linklayer/cantact-pro-hw/label-top.png

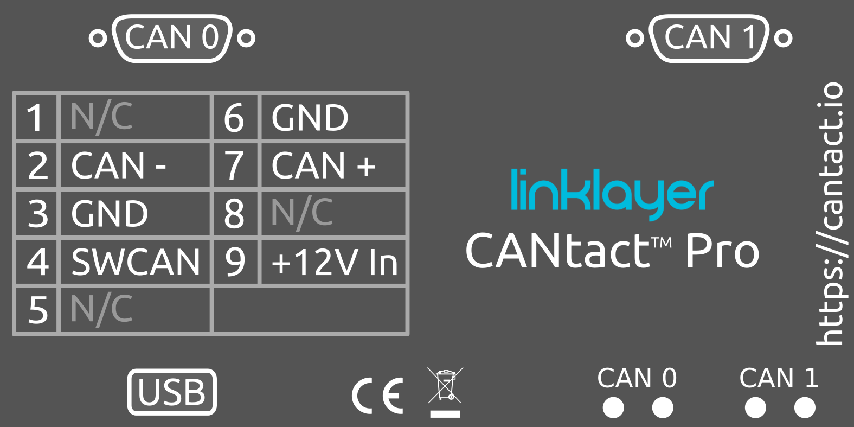
label-top.png
