linklayer/cantact-pro-hw/pcb.step

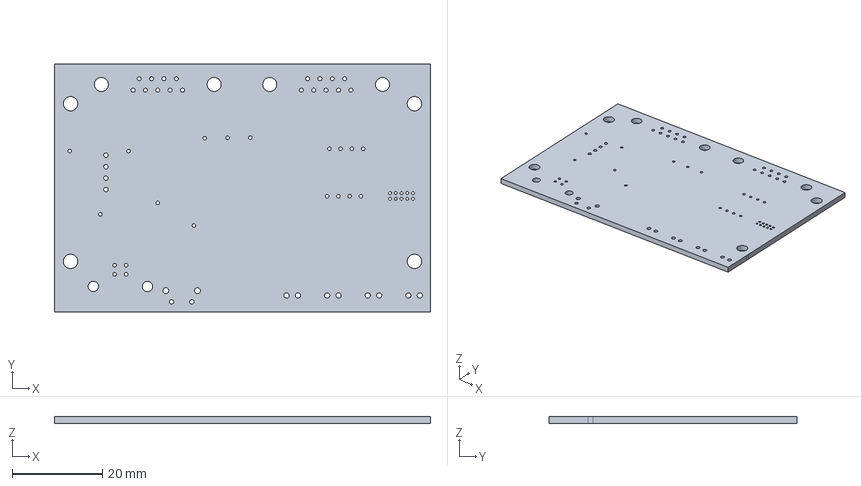
[picture p2: CAD file, 2020-08-20]
pcb.step
83.3 x 54.9 x 1.60 mm
