linklayer/cantact-pro-hw/cantactpro.pdf

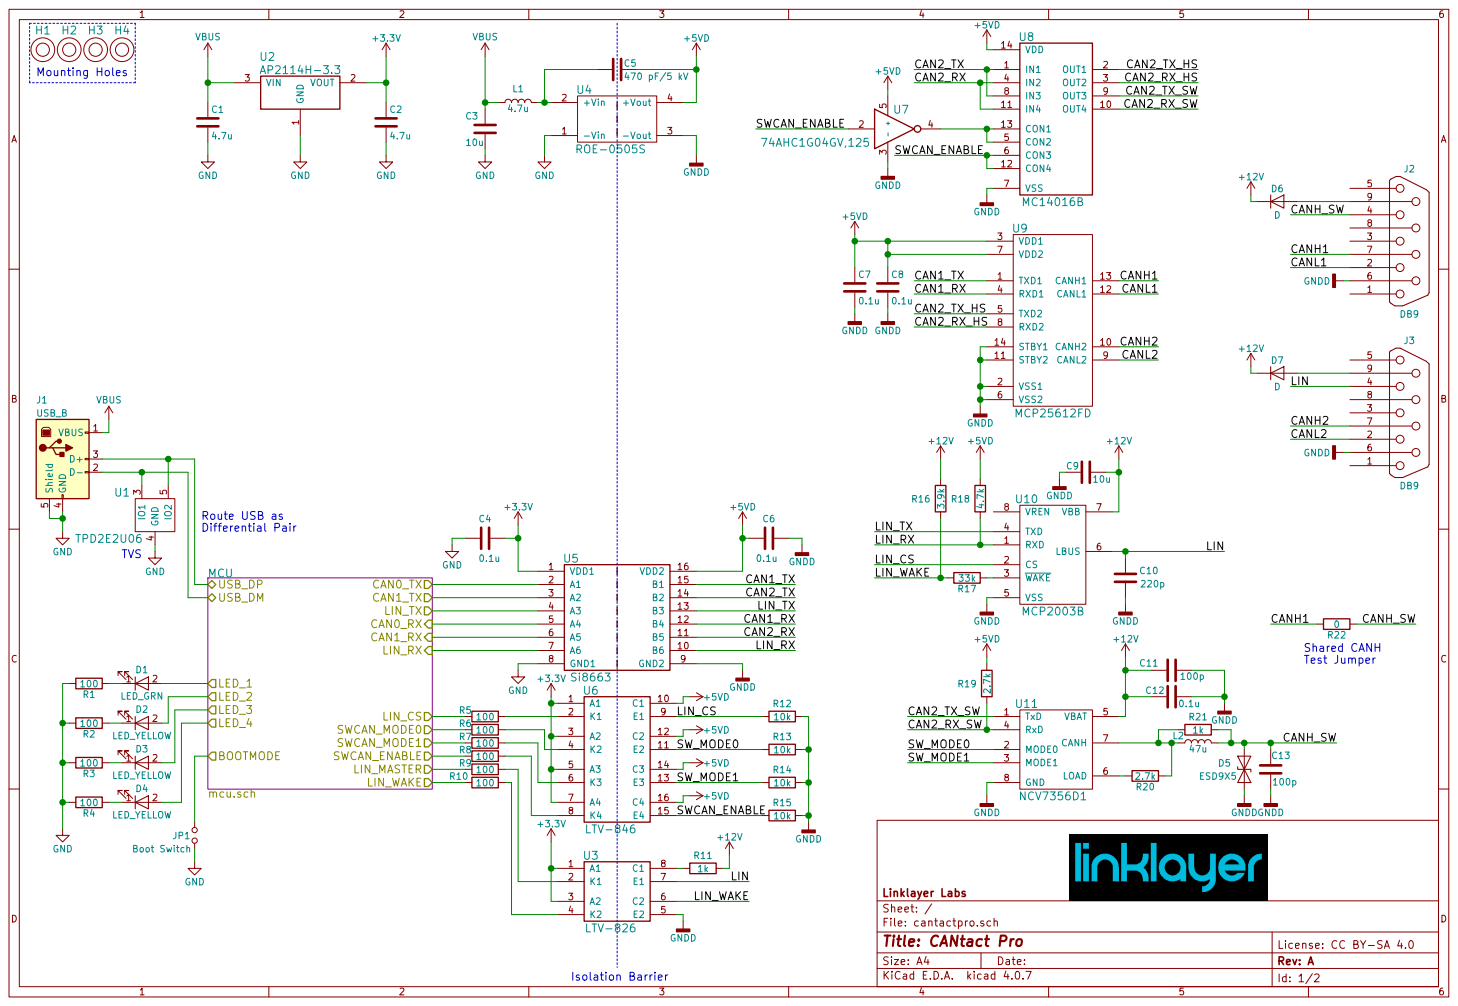
[picture p3: page 1]

LIN_RX

RXD 1 CS 2 WAKE 3 TXD 4 VSS 5

CAN0_TX CAN1_TX CAN1_RX SWCAN_MODE0 SWCAN_MODE1

File: cantactpro.sch Sheet: / Linklayer Labs

Id: 1/2 Title: CANtact Pro

License: CC BY-SA 4.0
