linklayer/cantact-pro-hw/cantactpro.kicad_pcb

## KiCad design cantactpro.kicad_pcb (2020-08-20)

Schematic: cantactpro.sch, CANtact FD

Parts:
C1, C2: 4.7u; C_0805; MPN CL21A475KAQNNNG
C3: 10u; C_0805; MPN CL21A106KPFNNNG
C4, C7, C11: 0.1u; C_0603; MPN CC0603ZRY5V9BB104
C5, C6: 470 pF/5 kV; C_1812; MPN 202S43W471KV4E
C8, C9: 0.1u; C_0603; MPN CL10F104ZO8NNNC
C10, C12: 100p; C_0603; MPN 885012206077
D1, D3: LED_GRN; LED_0603; MPN LTST-S270KGKT
D2, D4: LED_RED; LED_0603; MPN LTST-S270KRKT
D5: ESD9X5; SOD-923; MPN ESD9X5.0ST5G
D6: D; D_SMA; MPN S1G
H1, H2, H3, H4: MOUNT_HOLE; MountingHole_3.2mm_M3
J1: USB_B; MPN USB-B1HSB6
J2, J3: DB9; LD09P; MPN LD09P13A4GX00LF
JP1: Boot Switch; TE_1825027-5; MPN 1825027-5
L1: 4.7u; L_0805; MPN LQM21PN4R7NGRD
L2: 47u; L_1206; MPN LB3218T470K
LP1, LP2, LP3, LP4: Light Pipe; SLP3-150-zzz-x; MPN SLP3-150-100-F
R1, R2, R3, R4, R5, R6, R7: 100; R_0603; MPN ESR03EZPJ102
R8: 10k; R_0603; MPN RC0603JR-0710KL
R9, R10: 2.7k; R_0603; MPN RMCF0603JT2K70
R11: 1k; R_0603; MPN RC0603JR-071KL
TP1, TP2, TP3, TP4, TP5, TP6, TP7, TP8, TP9, TP10, TP11, TP12, TP13, TP14, TP15, TP16: TEST; Measurement_Point_Round-TH_Small
U1: TPD2E2U06; SOT-553; MPN TPD2E2U06DRLR
U2: AP2114H-3.3; SOT-223; MPN AP2114H-3.3TRG1
U3: ROE-0505S; MPN ROE-0505S
U4: Si864x; SOIC-16_3.9x9.9mm_Pitch1.27mm; MPN SI8642AB-B-IS1R
U5: LTV-846; SMD-16; MPN LTV-846S
U6, U11: 74LVC1G3157; SOT-363_SC-70-6; MPN SN74LVC1G3157DCKR
U7: NCV7356D1; SOIC-8_3.9x4.9mm_Pitch1.27mm; MPN NCV7356D1R2G
U8: MCP25612FD; SOIC-14_3.9x8.7mm_Pitch1.27mm; MPN MCP25612FD-H/SL
U9, U10: NUP2125; SC-70; MPN NUP2125WTT1G

Connections:
+3V3: C2.1, C4.1, TP3.1, U2.2, U2.4, U4.1, U4.7, U5.3, U5.5, U5.7; also elsewhere on the board
+5VD: C5.1, C7.2, C8.1, C9.1, R9.1, TP9.1, U3.4, U4.10, U4.16, U5.10, U5.12, U5.14, U6.5, U8.3, U8.7, U11.5
+12V: C10.1, C11.2, D6.1 (K), U7.5
/12V_DB9: D6.2 (A), J2.9
/CAN0_MODE: R8.2, TP14.1, U5.9, U6.6, U11.6
/CAN0_RX: TP12.1, U4.12, U11.4
/CAN0_RX_HS: U8.4, U11.3
/CAN0_RX_SW: R9.2, U7.4, U11.1
/CAN0_TX: TP10.1, U4.14, U6.4
/CAN0_TX_HS: U6.3, U8.1
/CAN0_TX_SW: U6.1, U7.1
/CAN1_RX: TP13.1, U4.11, U8.8
/CAN1_TX: TP11.1, U4.13, U8.5
/CANH0: J2.7, U8.13, U10.1
/CANH1: J3.7, U8.10, U9.1
/CANH_SW: C12.2, D5.1 (A1), J2.4, L2.2, R11.1
/CANL0: J2.2, U8.12, U10.2
/CANL1: J3.2, U8.9, U9.2
/MCU/BOOTMODE: JP1.1; also elsewhere on the board
/MCU/CAN0_RX: TP6.1, U4.5; also elsewhere on the board
/MCU/CAN0_TX: TP4.1, U4.3; also elsewhere on the board
/MCU/CAN1_RX: TP7.1, U4.6; also elsewhere on the board
/MCU/CAN1_TX: TP5.1, U4.4; also elsewhere on the board
/MCU/LED_1: D1.2 (A); also elsewhere on the board
/MCU/LED_2: D2.2 (A); also elsewhere on the board
/MCU/LED_3: D3.2 (A); also elsewhere on the board
/MCU/LED_4: D4.2 (A); also elsewhere on the board
/MCU/SWCAN_ENABLE: R7.1; also elsewhere on the board
/MCU/SWCAN_MODE0: R5.1; also elsewhere on the board
/MCU/SWCAN_MODE1: R6.1; also elsewhere on the board
/MCU/USB+: J1.3 (D+), U1.5; also elsewhere on the board
/MCU/USB-: J1.2 (D-), U1.3; also elsewhere on the board
/SW_MODE0: TP15.1, U5.13, U7.2
/SW_MODE1: TP16.1, U5.11, U7.3
GND: C1.2, C2.2, C3.2, C4.2, C6.2, J1.4 (GND), J1.5 (Shield), JP1.2, R1.1, R2.1, R3.1, R4.1, TP2.1, U1.4, U2.1, U3.1, U4.2, U4.8; also elsewhere on the board
GNDD: C6.1, C7.1, C8.2, C9.2, C10.2, C11.1, C12.1, D5.2 (A2), J2.3, J2.6, J3.3, J3.6, R8.1, TP8.1, U3.3, U4.9, U4.15, U6.2, U7.8, U8.2, U8.6, U8.11, U8.14, U9.3, U10.3, U11.2
unnamed: C5.2, L1.2, U3.2
unnamed: D1.1 (K), R1.2
unnamed: D2.1 (K), R2.2
unnamed: D3.1 (K), R3.2
unnamed: D4.1 (K), R4.2
unnamed: L2.1, R10.1, R11.2, U7.7
unnamed: R5.2, U5.4
unnamed: R6.2, U5.6
unnamed: R7.2, U5.8
unnamed: R10.2, U7.6
VBUS: C1.1, C3.1, J1.1 (VBUS), L1.1, TP1.1, U2.3; also elsewhere on the board

Notes on the sheet:
Isolation Barrier
Mounting Holes
Light Pipes

Schematic: mcu.sch, CANtact FD

Parts:
C13, C15, C17, C19, C21, C23, C25, C27, C29: 0.01u; C_0603; MPN C0603C103M5RACTU
C14, C16, C18, C20, C22, C24, C26, C28, C32: 0.1u; C_0603; MPN CL10F104ZO8NNNC
C30, C31: 33p; C_0603; MPN CL10C330JB8NNNC
C33: 4.7u; C_0805; MPN CL21A475KAQNNNG
C34: 10u; C_0805; MPN CL21A106KPFNNNG
J4: SWD; Pin_Header_Straight_2x05_Pitch1.27mm; MPN 3220-10-0100-00
R12: 0; R_0603; MPN RC0603JR-070RL
R13: 12.4k; R_0603; MPN ERJ-3EKF1242V
R14, R15: 10k; R_0603; MPN RC0603JR-0710KL
U12: LPC54616J512BD100; LQFP-100_14x14mm_Pitch0.5mm; MPN LPC54616J512BD100E
Y1: 12 MHz; CSM-3X; MPN ECS-120-20-3X-TR

Connections:
+3V3: C13.1, C14.1, C15.1, C16.1, C17.1, C18.1, C19.1, C20.1, C21.1, C22.1, C23.1, C24.1, C25.1, C26.1, C27.1, C28.1, C29.1, C32.1, C33.1, C34.1, J4.1, R14.2, R15.2, U12.1, U12.10, U12.11, U12.21, U12.31, U12.32, U12.33, U12.45, U12.50, U12.54, U12.75, U12.76, U12.99; also elsewhere on the board
/MCU/BOOTMODE: R12.2, U12.90; also elsewhere on the board
/MCU/CAN0_RX: U12.60; also elsewhere on the board
/MCU/CAN0_TX: U12.58; also elsewhere on the board
/MCU/CAN1_RX: U12.5; also elsewhere on the board
/MCU/CAN1_TX: U12.47; also elsewhere on the board
/MCU/ISP0: U12.87
/MCU/ISP1: R12.1, U12.89
/MCU/LED_1: U12.35; also elsewhere on the board
/MCU/LED_2: U12.36; also elsewhere on the board
/MCU/LED_3: U12.37; also elsewhere on the board
/MCU/LED_4: U12.38; also elsewhere on the board
/MCU/RESETN: J4.10, U12.48
/MCU/SWCAN_ENABLE: U12.77; also elsewhere on the board
/MCU/SWCAN_MODE0: U12.83; also elsewhere on the board
/MCU/SWCAN_MODE1: U12.78; also elsewhere on the board
/MCU/SWCLK: J4.4, R15.1, U12.24
/MCU/SWDIO: J4.2, R14.1, U12.25
/MCU/USB+: U12.13; also elsewhere on the board
/MCU/USB-: U12.12; also elsewhere on the board
GND: C13.2, C14.2, C15.2, C16.2, C17.2, C18.2, C19.2, C20.2, C21.2, C22.2, C23.2, C24.2, C25.2, C26.2, C27.2, C28.2, C29.2, C30.1, C31.1, C32.2, C33.2, C34.2, J4.3, J4.5, J4.9, R13.1, U12.2, U12.6, U12.14, U12.22, U12.30, U12.34, U12.49, U12.51, U12.53, U12.71, U12.79, U12.96; also elsewhere on the board
unnamed: C30.2, U12.20, Y1.2
unnamed: C31.2, U12.19, Y1.1
unnamed: R13.2, U12.7
VBUS: U12.9; also elsewhere on the board

Notes on the sheet:
SWD Debug Interface
DNP R14 for MSC Populate for DFU
TODO: CHECK LOAD CAPS

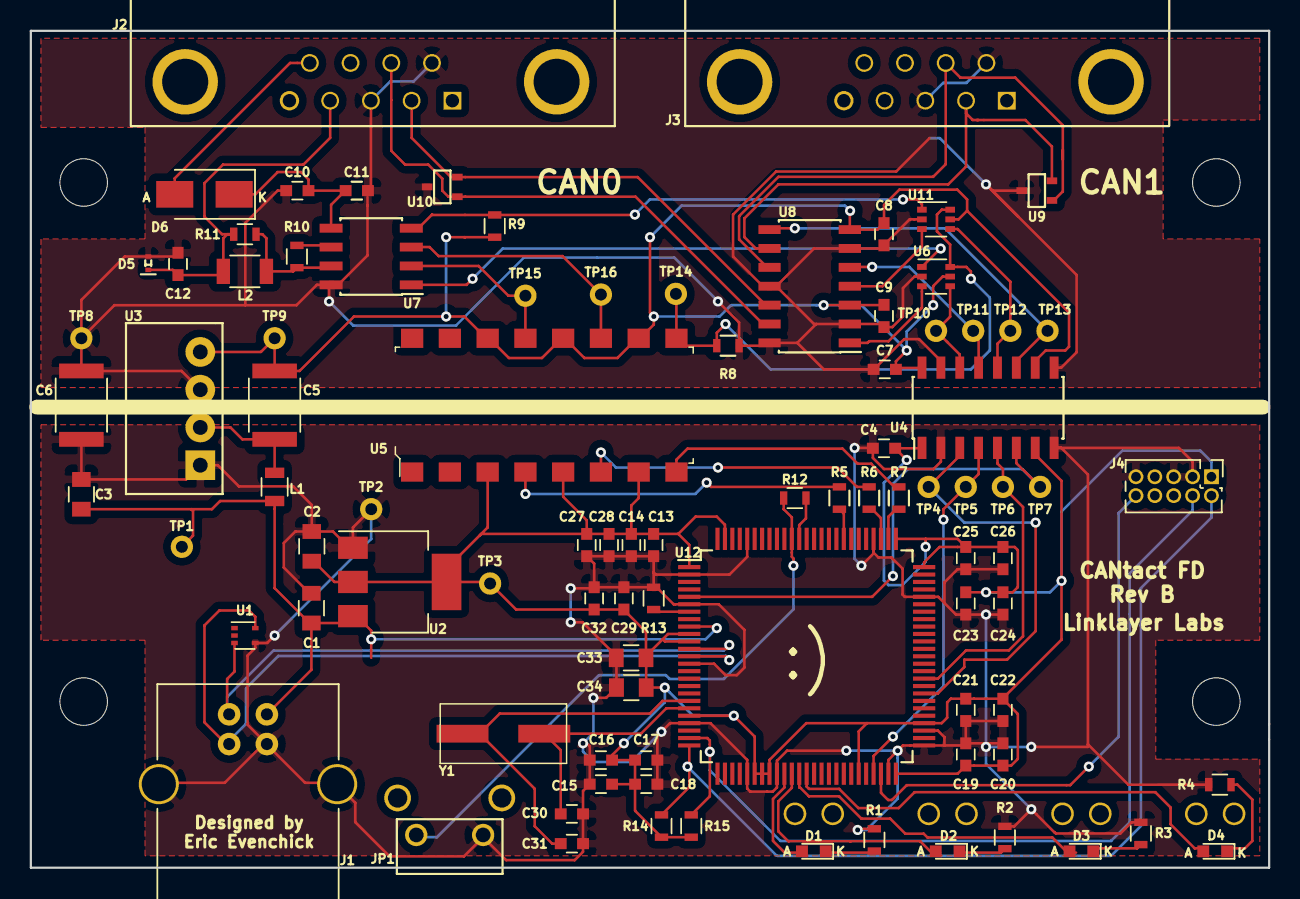
[picture p4: board cantactpro.kicad_pcb from above]

Board: 2 copper layers, 83.3 x 56.3 mm, 99 parts (0 on the bottom side), 54 nets.
